Kariboo-Corp/MAX20008-DevBoard/footprints+symbols/EEHZA1E470V.step

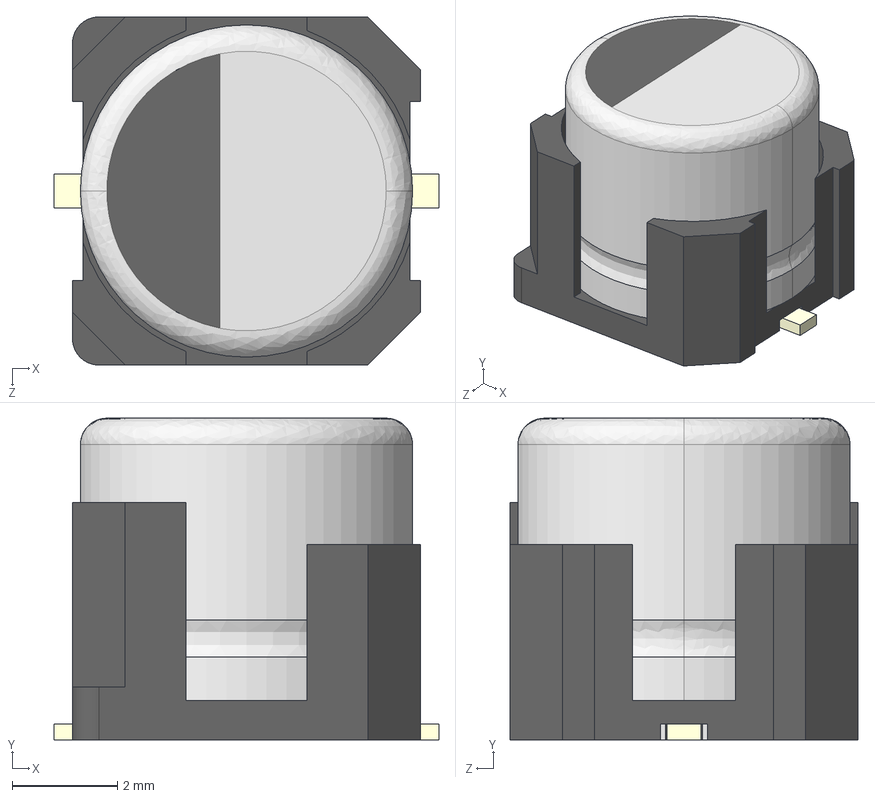
[picture p9: CAD file, 2023-02-09]
footprints+symbols/EEHZA1E470V.step
7.30 x 6.10 x 6.60 mm
