Kariboo-Corp/MAX20008-DevBoard/power supply prototype.kicad_pcb

## KiCad design power supply prototype.kicad_pcb (2023-02-10)

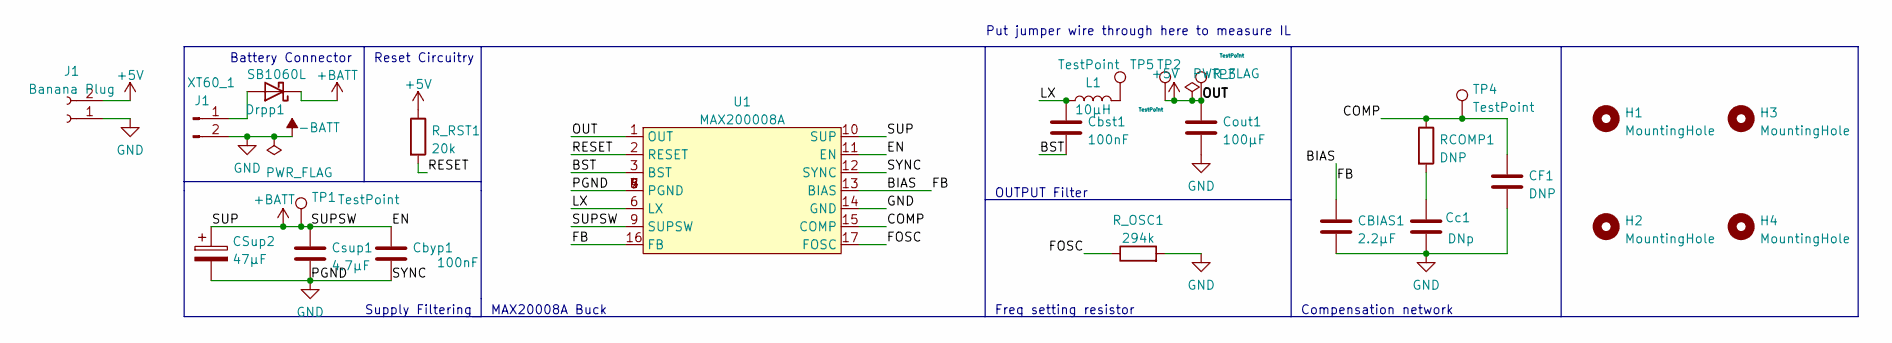
[picture p10: schematic power_supply.kicad_sch]

Parts:
CBIAS1: 2.2µF; C_0603_1608Metric_Pad1.08x0.95mm_HandSolder
CF1: DNP; C_0603_1608Metric_Pad1.08x0.95mm_HandSolder
CSup2: 47µF; CP_Elec_10x10.5; Part nb EEHZC1V470V
Cbst1: 100nF; C_0603_1608Metric_Pad1.08x0.95mm_HandSolder; part nb GCM188R71H104KA57D
Cbyp1: 100nF; C_0603_1608Metric_Pad1.08x0.95mm_HandSolder
Cc1: DNp; C_0603_1608Metric_Pad1.08x0.95mm_HandSolder
Cout1: 100µF; C_1210_3225Metric; part nb GRM32ER61A107ME20L
Csup1: 4.7µF; C_0603_1608Metric_Pad1.08x0.95mm_HandSolder
Drpp1: SB1060L; TO_277B
H1, H2, H3, H4: MountingHole; MountingHole_4.3mm_M4
J1: Banana Plug; Banana_Jack_2Pin
L1: 10µH; SRP1265C; Part nb EEHZA1E470V
RCOMP1: DNP; R_0603_1608Metric_Pad0.98x0.95mm_HandSolder
R_OSC1: 294k; R_0603_1608Metric_Pad0.98x0.95mm_HandSolder
R_RST1: 20k; R_0603_1608Metric_Pad0.98x0.95mm_HandSolder
TP1, TP2, TP3, TP4, TP5: TestPoint; TestPoint_THTPad_2.0x2.0mm_Drill1.0mm
U1: MAX200008A; MAX20008AFOB&slash_VY&plus_
XT60_1: J1; XT60 conn

Connections:
+5V: Cout1.1, J1.2, R_RST1.1, TP2.1, TP3.1, U1.1 (OUT); also elsewhere on the board
+BATT: CSup2.1, Cbyp1.1, Csup1.1, Drpp1.1 (K), TP1.1, U1.9 (SUPSW), U1.10 (SUP), U1.11 (EN)
-BATT: CBIAS1.2, CF1.2, CSup2.2, Cbyp1.2, Cc1.2, Cout1.2, Csup1.2, J1.1, R_OSC1.2, U1.4 (PGND), U1.5 (PGND), U1.7 (PGND), U1.8 (PGND), U1.12 (SYNC), U1.14 (GND), XT60_1.2; also elsewhere on the board
/power supply/BIAS: CBIAS1.1, U1.13 (BIAS), U1.16 (FB)
/power supply/BST: Cbst1.2, U1.3 (BST)
/power supply/COMP: CF1.1, RCOMP1.1, TP4.1, U1.15 (COMP)
/power supply/FOSC: R_OSC1.1, U1.17 (FOSC)
/power supply/LX: Cbst1.1, L1.1, U1.6 (LX)
/power supply/RESET: R_RST1.2, U1.2 (RESET)
unnamed: Cc1.1, RCOMP1.2
unnamed: Drpp1.2 (A), XT60_1.1
unnamed: L1.2, TP5.1

Notes on the sheet:
Freq setting resistor
OUTPUT Filter
Compensation network
Supply Filtering
Put jumper wire through here to measure IL
Reset Circuitry
Battery Connector
MAX20008A Buck

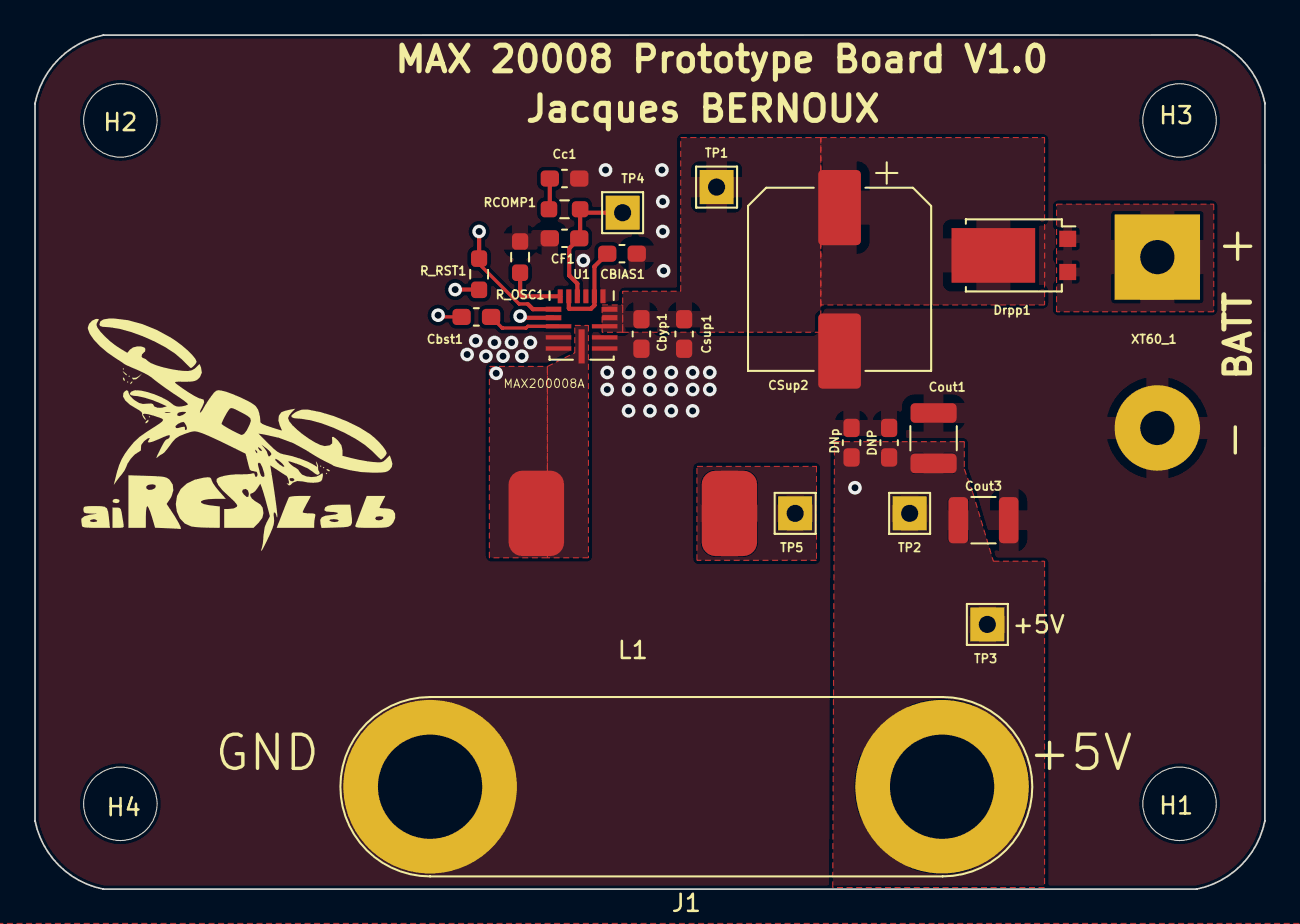
[picture p11: board power supply prototype.kicad_pcb from above]

Board: 4 copper layers, 72.0 x 50.0 mm, 28 parts (0 on the bottom side), 12 nets.

Other parts of the board:
Cout3: DNP; C_1210_3225Metric
DNP: C_0603_1608Metric_Pad1.08x0.95mm_HandSolder
DNp: C_0603_1608Metric_Pad1.08x0.95mm_HandSolder

Their connections:
+5V: Cout3.1, DNP.1, DNp.1; also elsewhere on the board
-BATT: Cout3.2, DNP.2, DNp.2; also elsewhere on the board
